kruparellia/claude-contribution-/vision/refs/red_rock_close/10.jpg

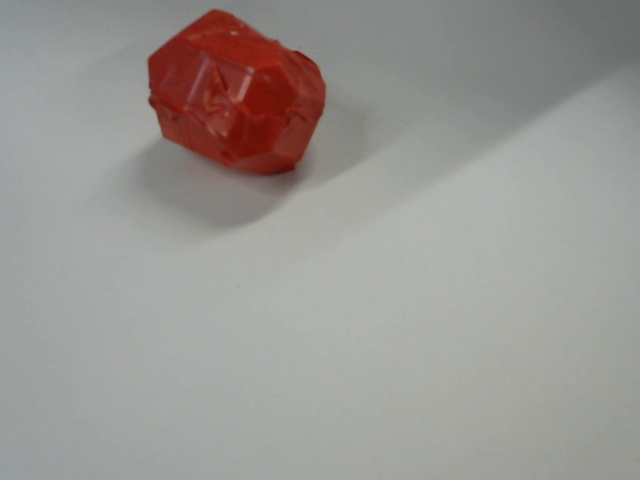
vision/refs/red_rock_close/10.jpg
