kruparellia/claude-contribution-/vision/refs/red_rock_oldcam/08.jpg

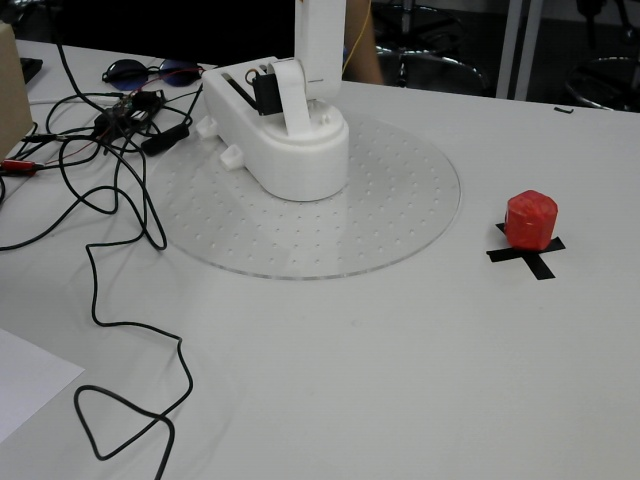
vision/refs/red_rock_oldcam/08.jpg
