kruparellia/claude-contribution-/README.md

# Embeded-Robot-Arm-CW
Advanced Industrial Robotic Arm using RF Wireless Communication for Industrial Applications. This is for our Embedded Systems Year 3 coursework.
