kruparellia/claude-contribution-/EE6003_Report/sections/09_teamwork.tex

% =====================================================================
% Teamwork & individual contributions  (~150 words; thin first draft)
% =====================================================================
\section{Teamwork and Individual Contributions}
\label{sec:teamwork}

The team of three partitioned work along the lines suggested by the
marking rubric. \textbf{Member~A} (mechanical lead) was responsible
for the SolidWorks design, 3D printing iterations and physical
assembly. \textbf{Member~B} (electronics lead) led hardware
schematics, sensor interfacing and wiring of both units.
\textbf{Member~C} (integration lead, the present author) led firmware,
the wireless protocol design, the autonomous-mode FSM, the
computer-vision integration and the report write-up. All three
members participated in testing and in producing the demonstration
video.

% TODO: insert the agreed Gantt chart / task allocation table once
% the team has finalised the per-week breakdown.
\begin{table}[t]
  \centering
  \caption{Individual contribution summary (to be finalised).}
  \footnotesize
  \begin{tabularx}{\columnwidth}{lX}
    \toprule
    \textbf{Member} & \textbf{Primary contributions} \\
    \midrule
    A & CAD, 3D printing, mechanical assembly, gripper iterations \\
    B & Schematics, sensor interfacing, power architecture, wiring \\
    C & Firmware, protocol, FSM, vision, integration, report \\
    \bottomrule
  \end{tabularx}
\end{table}

Independent peer feedback will be submitted to the module lead via
Canvas as required by the brief.
