kruparellia/claude-contribution-/EE6003_Report_Scaffold/sections/09_teamwork.tex

% =====================================================================
% Teamwork & Individual Contributions  --  TARGET: ~250 words
% Marking weight: 10 marks. Submitted in the report;
% confidential peer-feedback goes separately to Canvas per the brief.
% =====================================================================
\section{Teamwork and Individual Contributions}
\label{sec:teamwork}

\guide{
The brief's individual-contribution requirement covers eight
deliverable areas (Abstract / Lit Review, System Design, Hardware,
Software, Mechanical/CAD, Testing, Teamwork, Report Writing). Map
each member to the areas they led. The 1st+ rubric wants
``exceptional teamwork with outstanding coordination and equal
contribution.''

For top marks, include:
\begin{itemize}
  \item A contribution table (member $\rightarrow$ areas led).
  \item One paragraph per member describing primary contributions,
        impact on the team, and any cross-area support given.
  \item A short paragraph on team process: how tasks were allocated,
        how blockers were escalated, how decisions were recorded.
  \item Brief mention that confidential peer feedback was submitted
        independently to the module lead via Canvas, as required.
\end{itemize}
Avoid: blame, vague contributions like ``helped with everything'',
or unbalanced framing.
}

\subsection{Contribution summary}
\placeholder{[\ldots brief paragraph introducing the three members
and their lead areas\ldots]}

\begin{table}[t]
  \centering
  \caption{Individual contribution summary.}
  \footnotesize
  \begin{tabularx}{\columnwidth}{lX}
    \toprule
    \textbf{Member} & \textbf{Primary contributions} \\
    \midrule
    A & [\ldots e.g.\ CAD, 3D printing, mechanical assembly\ldots] \\
    B & [\ldots e.g.\ schematics, sensor interfacing, power\ldots] \\
    C & [\ldots e.g.\ firmware, protocol, FSM, integration\ldots] \\
    \bottomrule
  \end{tabularx}
\end{table}

\subsection{Team process}
\placeholder{[\ldots one paragraph: weekly stand-ups, shared task
board, source-control workflow (Git), and how blockers were
escalated and resolved\ldots]}

\subsection{Peer feedback}
\placeholder{[\ldots one short paragraph noting that each member
submitted confidential professional feedback for the other two
members directly to the module lead via Canvas, as required by the
brief\ldots]}
