kruparellia/claude-contribution-/EE6003_Report_Scaffold/sections/10_conclusion.tex

% =====================================================================
% Discussion, Future Work & Conclusion  --  TARGET: ~300 words
% =====================================================================
\section{Discussion and Future Work}
\label{sec:futurework}

\guide{
This section pulls together the advanced-feature claims that justify
marks above the 60\,\% ceiling. List them explicitly, in priority
order, then say what the next planned extensions are.

For Future Work, the highest-credibility extensions are ones that
build on infrastructure you've already laid. Strong candidates:
\begin{itemize}
  \item Migrate Mega super-loop to ArduinoFreeRTOS task scheduling
        (the firmware was already structured to allow this).
  \item Add an nRF24L01+ as a redundant wireless channel.
  \item Replace 3D-printed gears with anti-backlash pairs.
  \item Add a force-sensitive gripper for grasp-quality feedback.
  \item ESP32 / Pi vision pipeline migration to ML-based
        classification (e.g.\ MobileNet on the Pi).
\end{itemize}
Pick three or four; explain what each one would require and what
metric it would improve.
}

\placeholder{[\ldots one paragraph listing the principal
advanced-feature claims of this submission, with brief justification
for each\ldots]}

\placeholder{[\ldots one paragraph on planned extensions, prioritised,
each with the metric it improves\ldots]}

\section{Conclusion}
\label{sec:conclusion}

\guide{
Three sentences:
\begin{enumerate}
  \item One sentence stating what was built.
  \item One sentence stating that all six brief objectives are
        addressed.
  \item One sentence stating which advanced features push the grade
        above the upper-2:1 ceiling.
\end{enumerate}
End with a sentence pointing to the demonstration video and code in
the supplementary zip.
}

\placeholder{[\ldots three to four sentences. End with a pointer to
the demonstration video and the supplementary code archive.\ldots]}
