kruparellia/claude-contribution-/EE6003_Report/figures/01_power_architecture.pdf

## Power architecture — arm side

Servos and Arduino get power from different sources. Grounds are tied together.

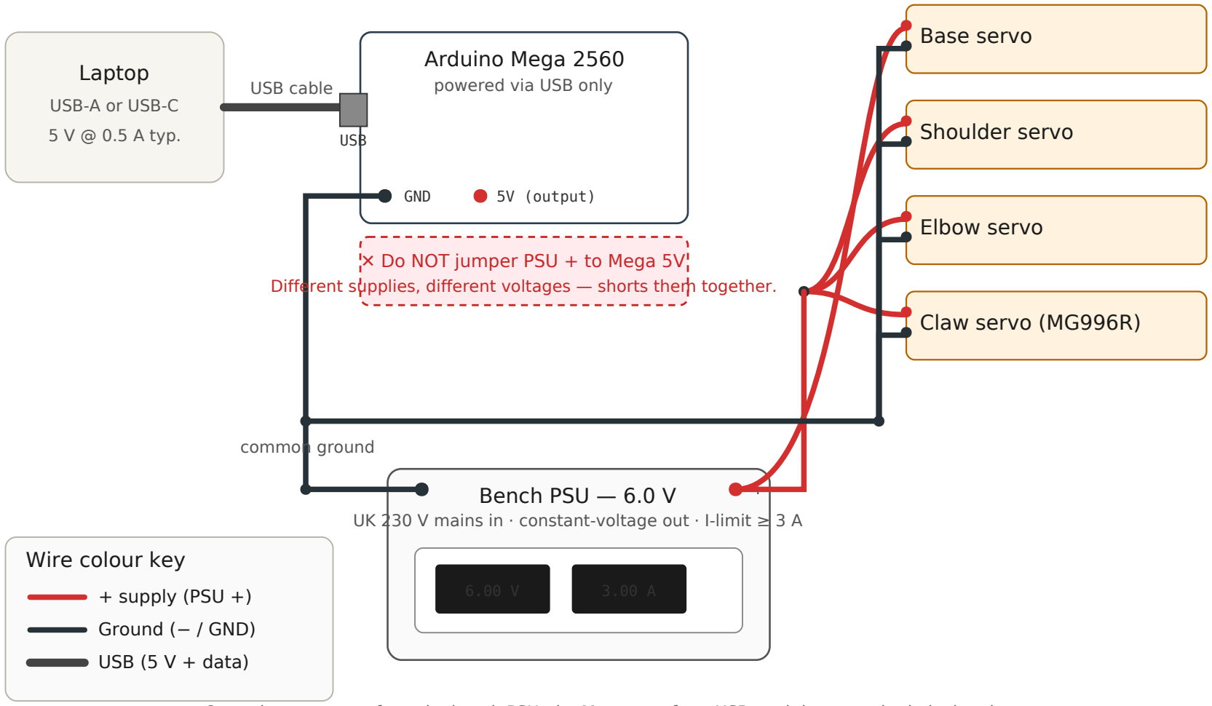
[picture p3: figure]
Laptop; USB-A or USB-C; 5 V @ 0.5 A typ.; USB cable; Arduino Mega 2560 powered via USB only; USB; GND; 5V (output); Base servo; Shoulder servo; Elbow servo; Claw servo (MG996R); Bench PSU — 6.0 V; common ground; ✕ Do NOT jumper PSU + to Mega 5V; Wire colour key; + supply (PSU +); Ground (− / GND); USB (5 V + data)

UK 230 V mains in · constant-voltage out · I-limit ≥ 3 A

Different supplies, different voltages — shorts them together.

One rule: servos eat from the bench PSU, the Mega eats from USB, and the grounds shake hands.
