kruparellia/claude-contribution-/EE6003_Report/figures/02_hc05_voltage_divider.pdf

## HC-05 RX voltage divider

Drops the Arduino's 5 V TX signal to ≈ 3.3 V before it reaches the HC-05 RX V_out = 5 V × R2 / (R1 + R2) = 5 × 2/3 ≈ 3.33 V

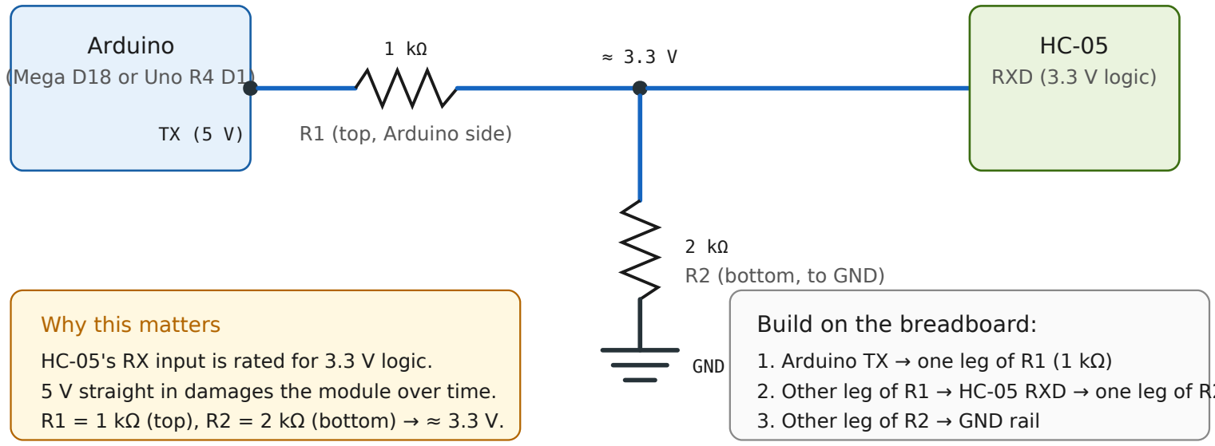
[picture p4: figure]
Arduino (Mega D18 or Uno R4 D1); R1 (top, Arduino side); RXD (3.3 V logic); 2 kΩ R2 (bottom, to GND); GND (shared); Why this matters; Build on the breadboard:; 1. Arduino TX → one leg of R1 (1 kΩ); 3. Other leg of R2 → GND rail

HC-05's RX input is rated for 3.3 V logic.
5 V straight in damages the module over time. R1 = 1 kΩ (top), R2 = 2 kΩ (bottom) → ≈ 3.3 V.
2. Other leg of R1 → HC-05 RXD → one leg of R2 (2 kΩ
