kruparellia/claude-contribution-/vision/markers/aruco_sheet_20mm_ids5-6-7-8.pdf

ID 5 20mm | ID 6 20mm | ID 7 20mm | ID 8 20mm

verify: 25 mm

## CLAW TIP — ArUco DICT_4X4_50 20 mm IDs [5, 6, 7, 8]
