kruparellia/claude-contribution-/vision/markers/aruco_id10_50mm.pdf

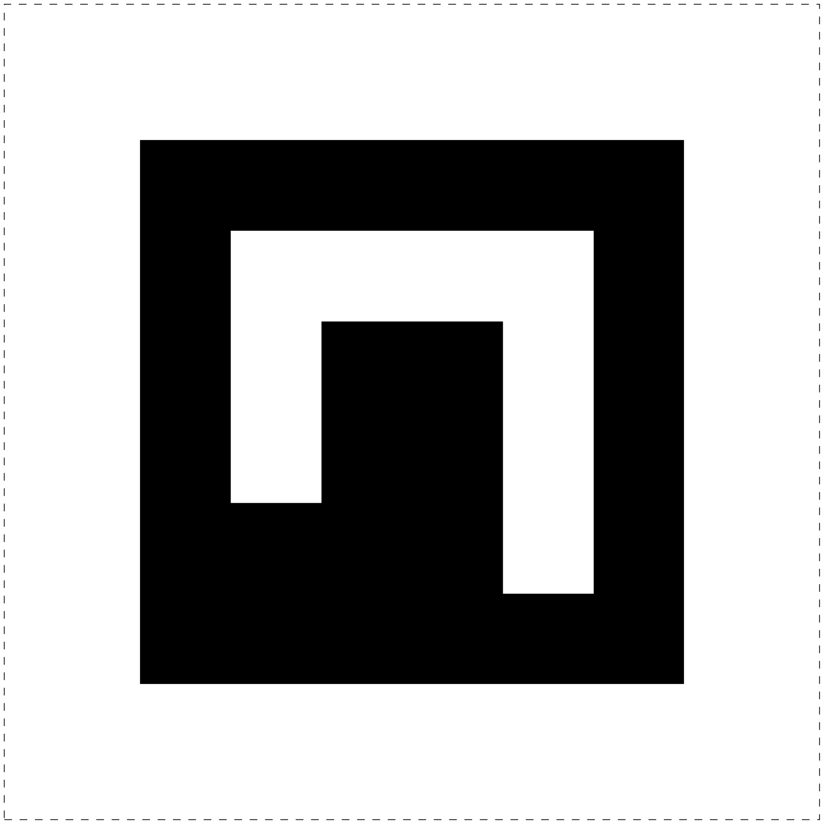
[picture p5: figure]

BASE HEADING — ArUco DICT_4X4_50 ID 10 50 mm

verify: 25 mm
