kruparellia/claude-contribution-/vision/markers/aruco_id00_25mm.pdf

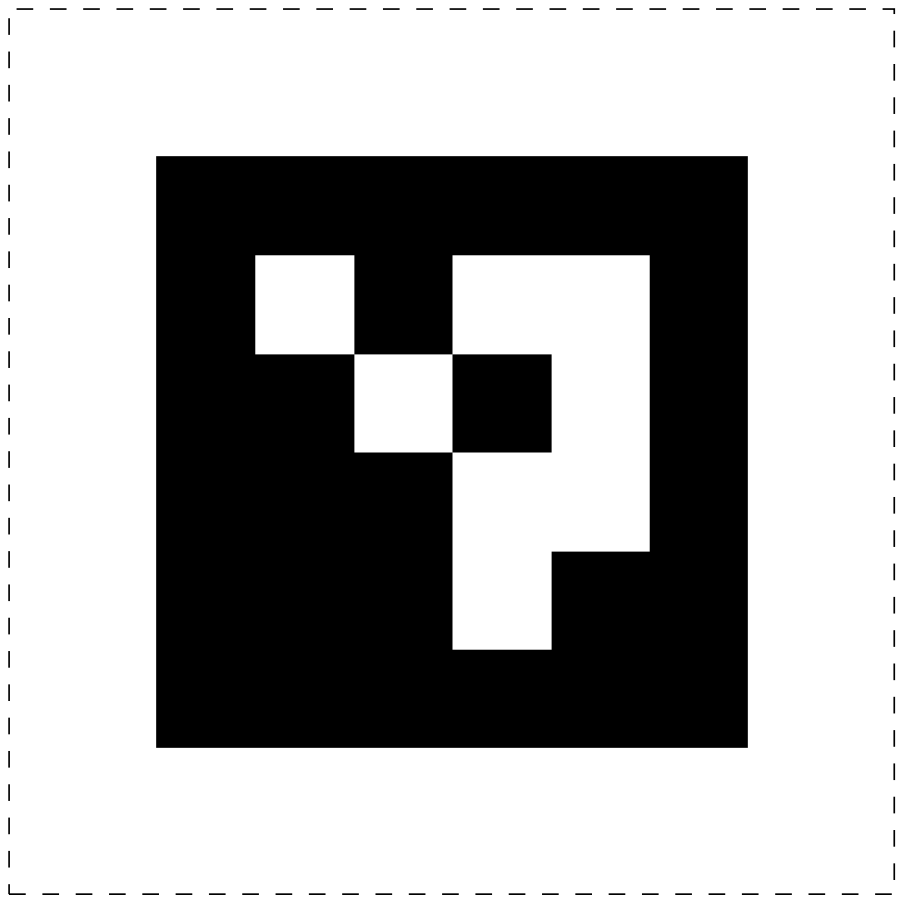
[picture p6: figure]

ArUco DICT_4X4_50 ID 0 25 mm

verify: 25 mm
