kruparellia/claude-contribution-/vision/markers/aruco_id01_25mm.pdf

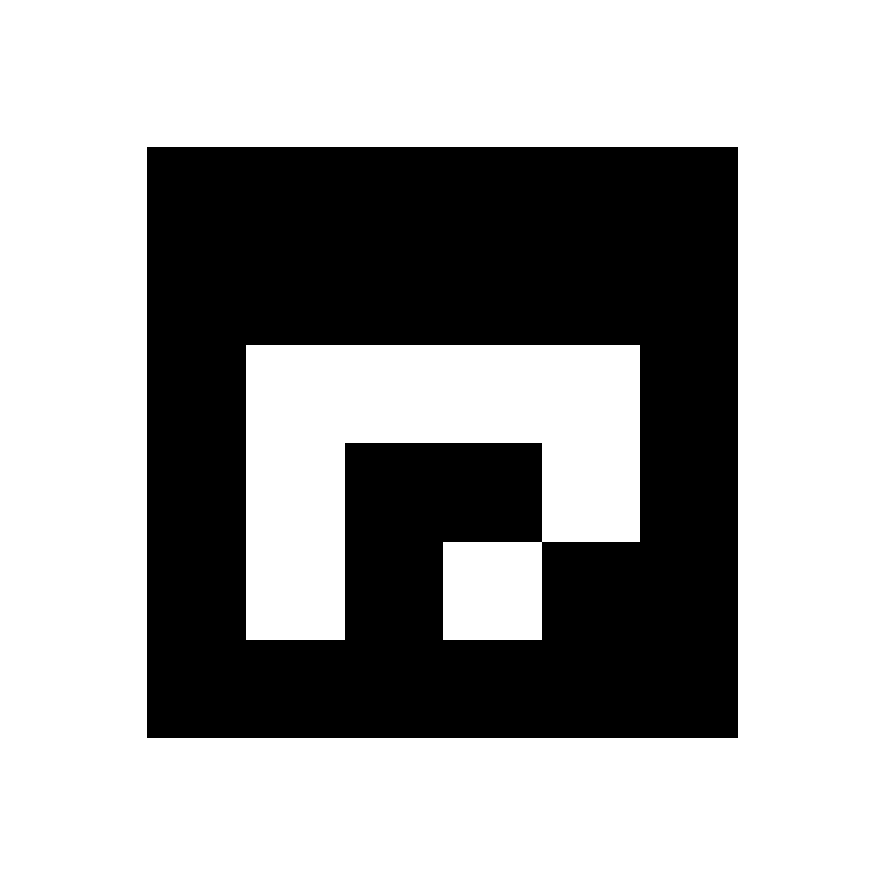
[picture p7: figure]

ArUco DICT_4X4_50 ID 1 25 mm

verify: 25 mm
