kruparellia/claude-contribution-/vision/markers/aruco_id02_25mm.pdf

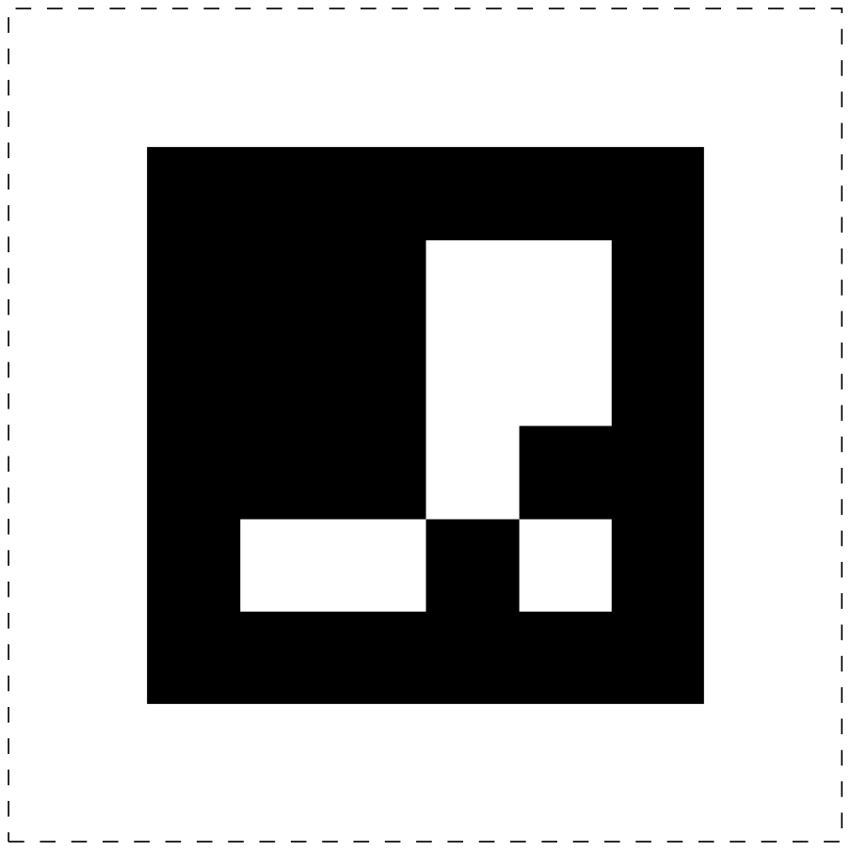
[picture p8: figure]

ArUco DICT_4X4_50 ID 2 25 mm

verify: 25 mm
