kruparellia/claude-contribution-/vision/markers/aruco_id03_25mm.pdf

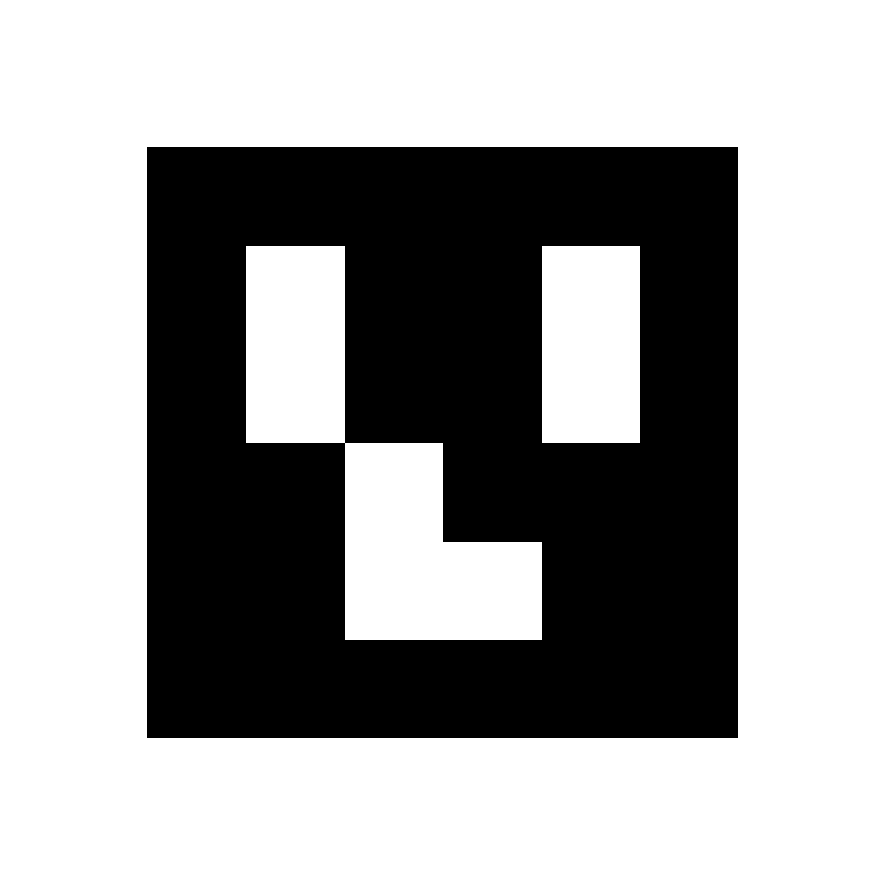
[picture p9: figure]

ArUco DICT_4X4_50 ID 3 25 mm

verify: 25 mm
