kruparellia/claude-contribution-/vision/markers/aruco_id00_25mm.png

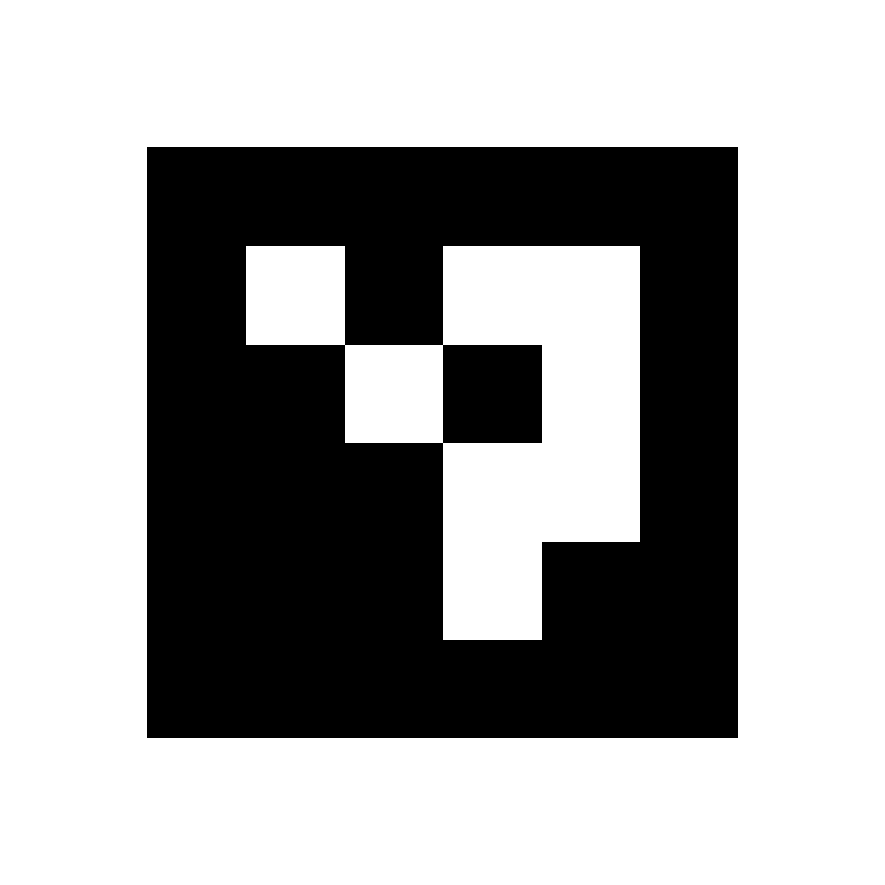
vision/markers/aruco_id00_25mm.png
