kruparellia/claude-contribution-/vision/markers/aruco_id02_25mm.png

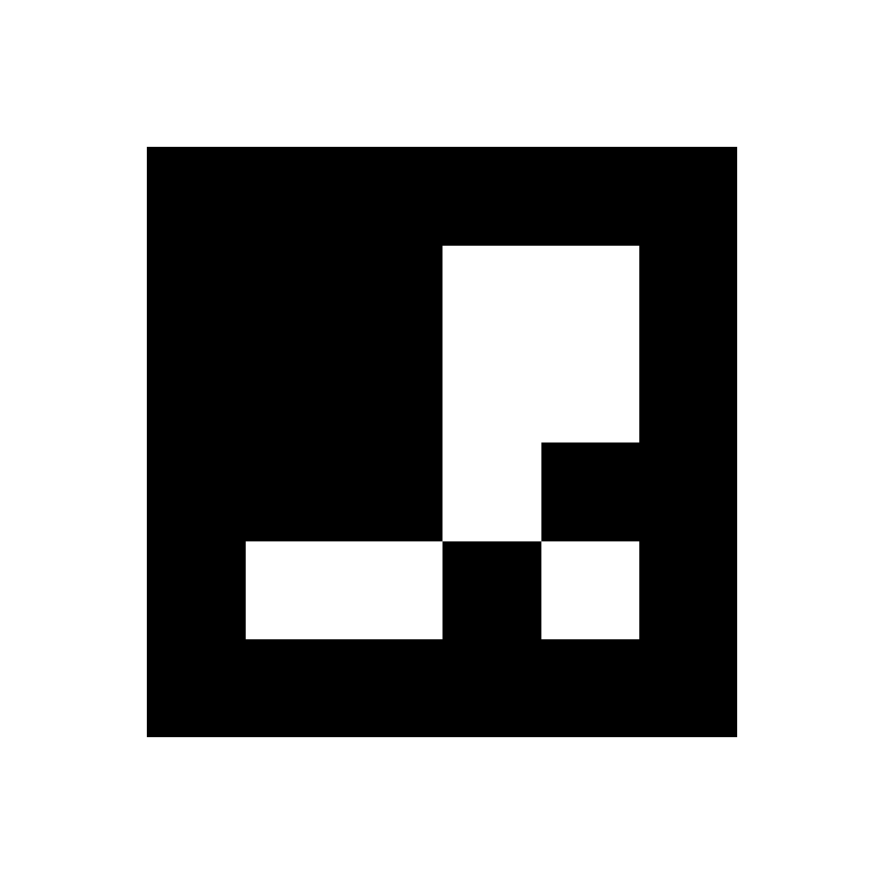
vision/markers/aruco_id02_25mm.png
