kruparellia/claude-contribution-/vision/markers/aruco_id10_50mm.png

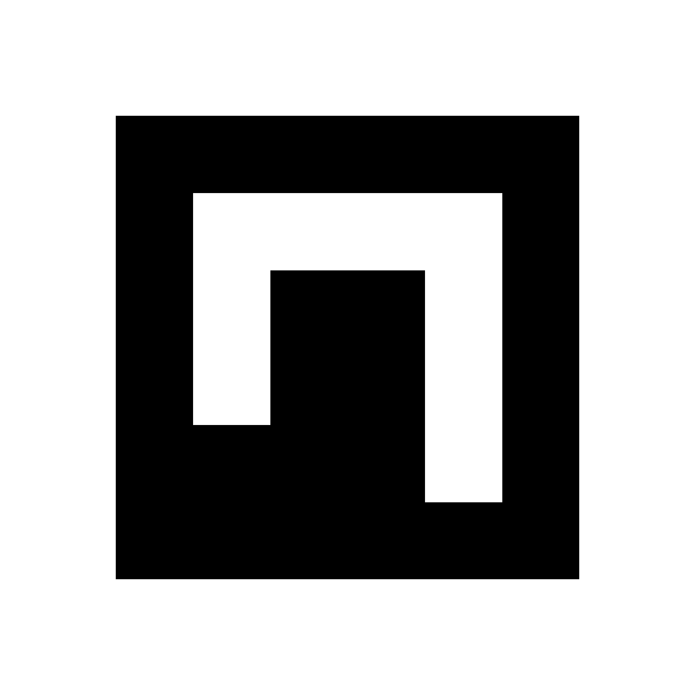
vision/markers/aruco_id10_50mm.png
