kruparellia/claude-contribution-/vision/refs/red_rock_close/01.jpg

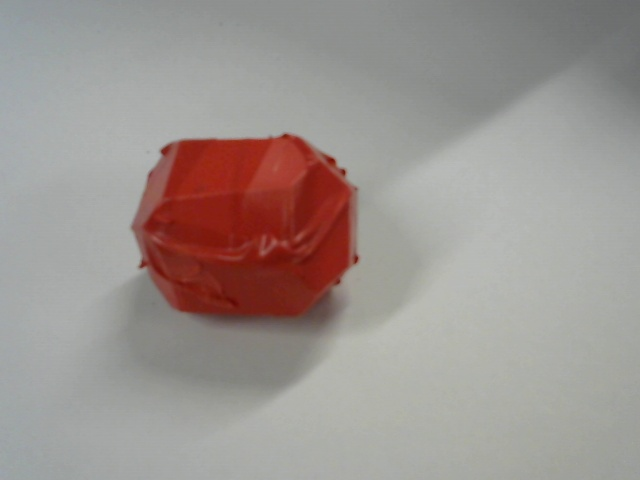
vision/refs/red_rock_close/01.jpg
