kruparellia/claude-contribution-/vision/refs/red_rock_close/03.jpg

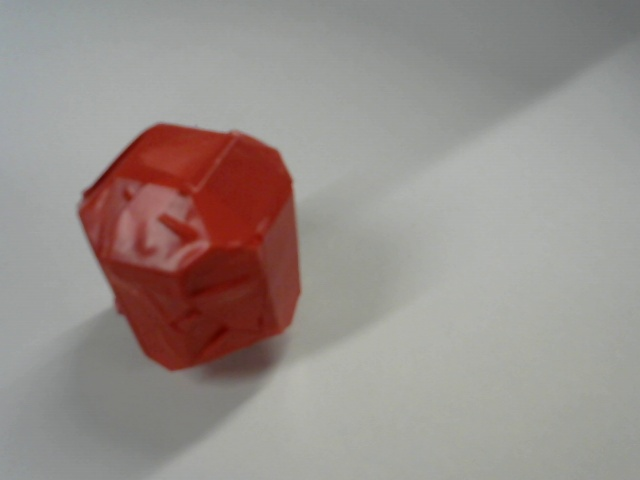
vision/refs/red_rock_close/03.jpg
