kruparellia/claude-contribution-/vision/refs/red_rock_close/04.jpg

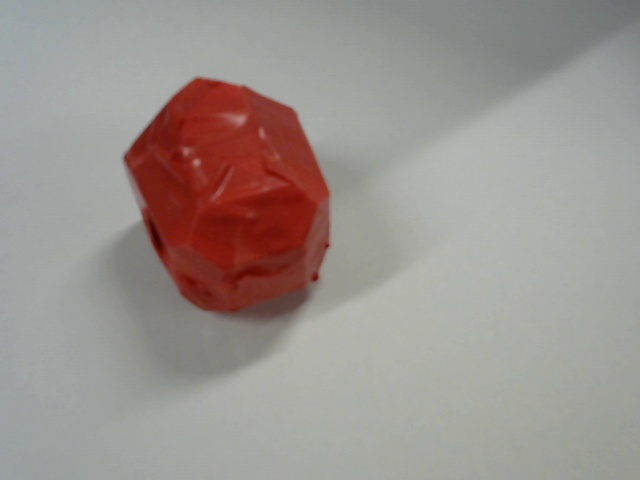
vision/refs/red_rock_close/04.jpg
