kruparellia/claude-contribution-/vision/refs/red_rock_close/05.jpg

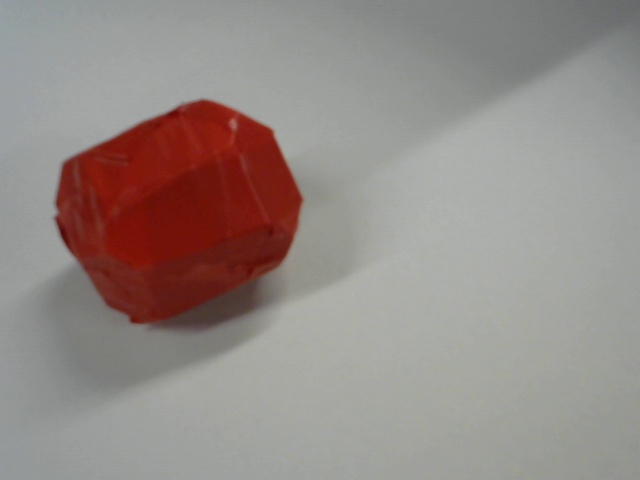
vision/refs/red_rock_close/05.jpg
