kruparellia/claude-contribution-/vision/refs/red_rock_close/06.jpg

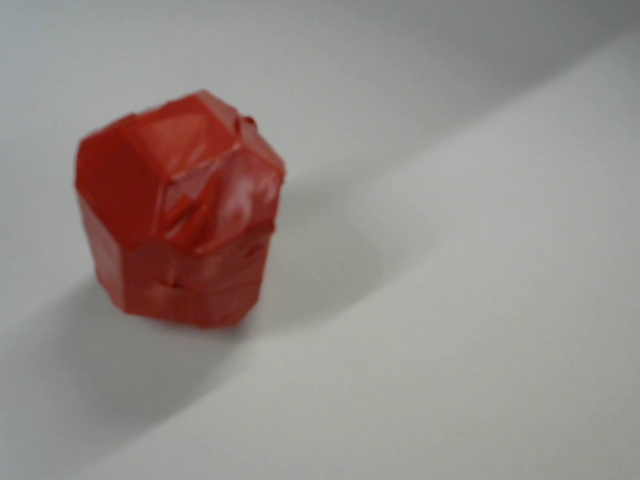
vision/refs/red_rock_close/06.jpg
