kruparellia/claude-contribution-/vision/refs/red_rock_close/07.jpg

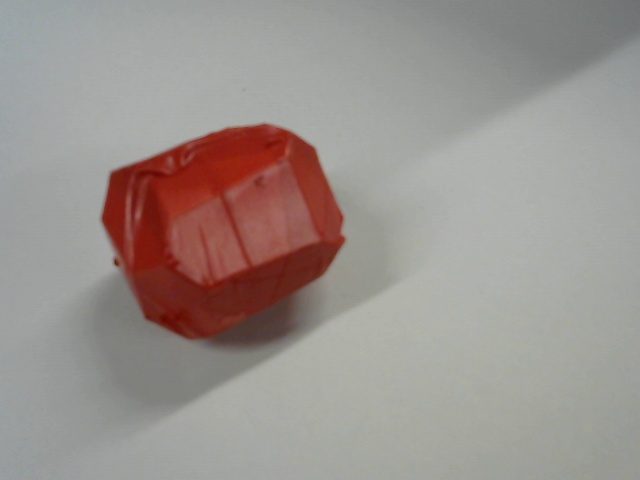
vision/refs/red_rock_close/07.jpg
