kruparellia/claude-contribution-/vision/refs/red_rock_close/08.jpg

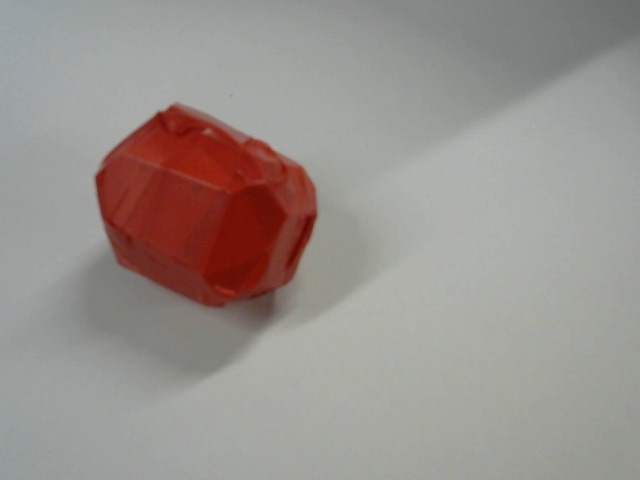
vision/refs/red_rock_close/08.jpg
