kruparellia/claude-contribution-/vision/refs/red_rock_close/11.jpg

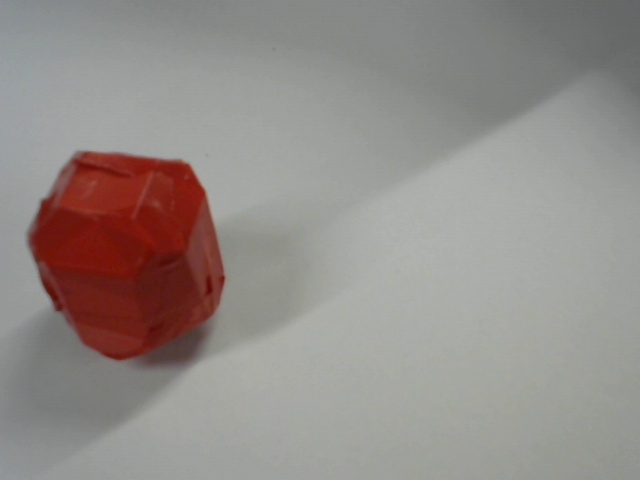
vision/refs/red_rock_close/11.jpg
