kruparellia/claude-contribution-/vision/refs/red_rock_close/12.jpg

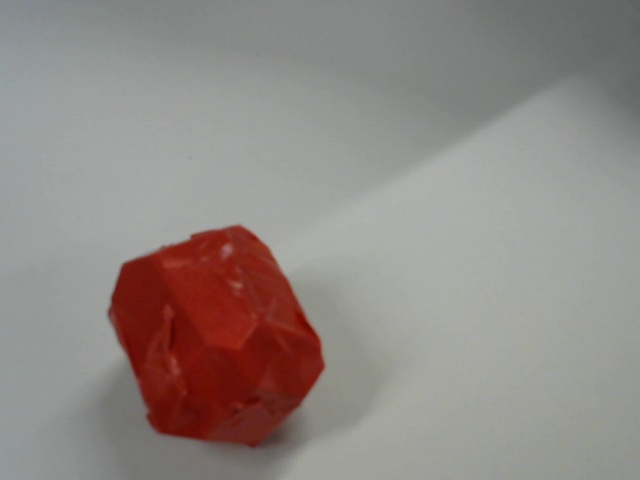
vision/refs/red_rock_close/12.jpg
