kruparellia/claude-contribution-/vision/refs/red_rock_close/13.jpg

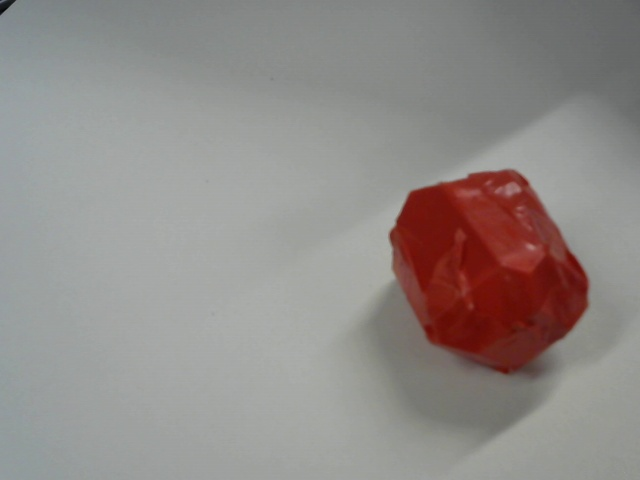
vision/refs/red_rock_close/13.jpg
