kruparellia/claude-contribution-/vision/refs/red_rock_close/14.jpg

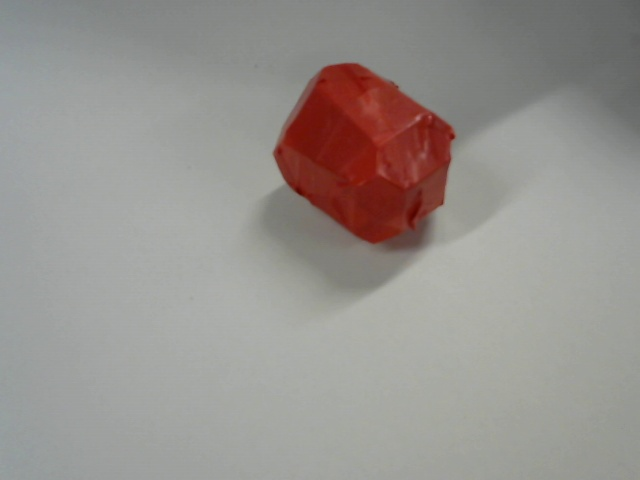
vision/refs/red_rock_close/14.jpg
