kruparellia/claude-contribution-/vision/refs/red_rock_close/15.jpg

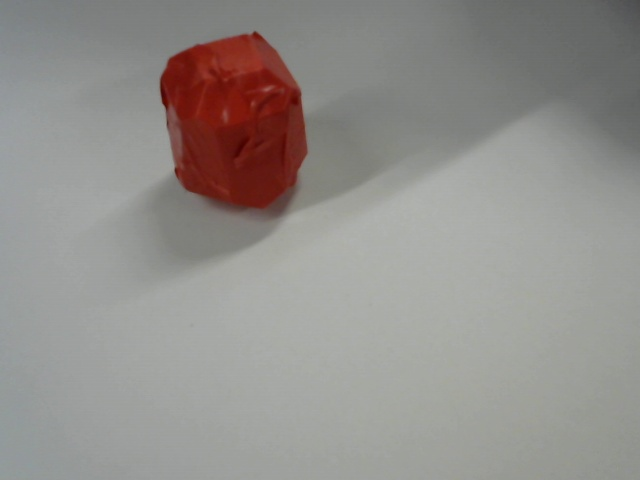
vision/refs/red_rock_close/15.jpg
