kruparellia/claude-contribution-/vision/refs/red_rock_close/17.jpg

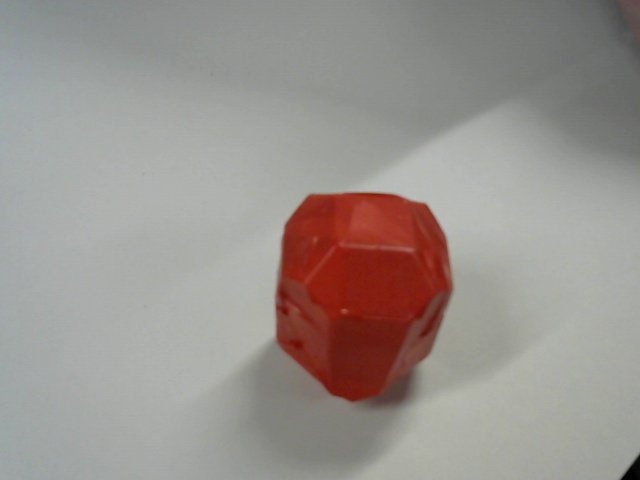
vision/refs/red_rock_close/17.jpg
