kruparellia/claude-contribution-/vision/refs/red_rock_close/18.jpg

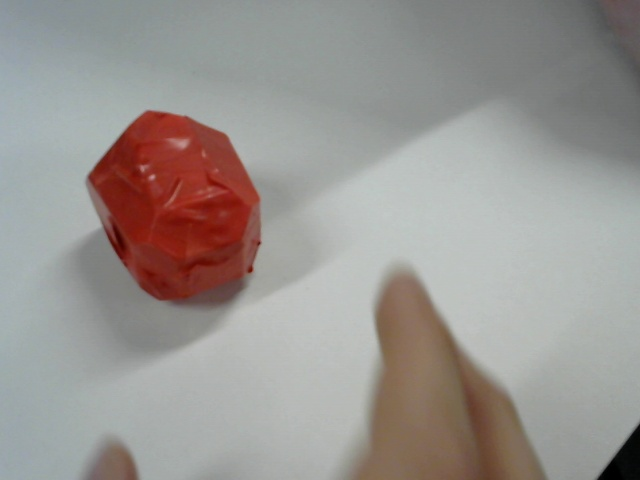
vision/refs/red_rock_close/18.jpg
