kruparellia/claude-contribution-/vision/refs/red_rock_oldcam/17.jpg

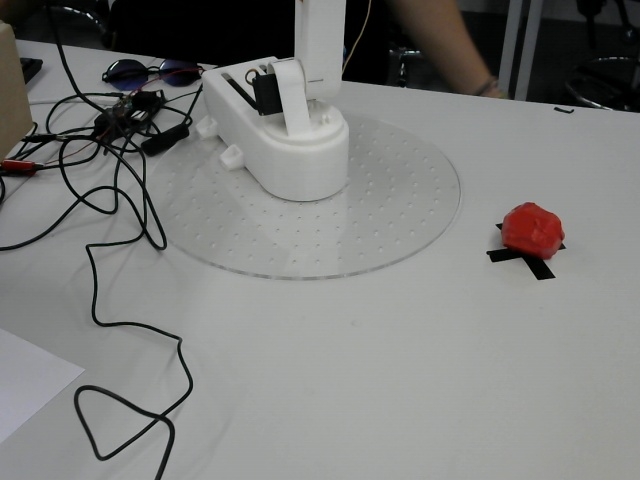
vision/refs/red_rock_oldcam/17.jpg
