kruparellia/claude-contribution-/vision/refs/red_rock_oldcam/19.jpg

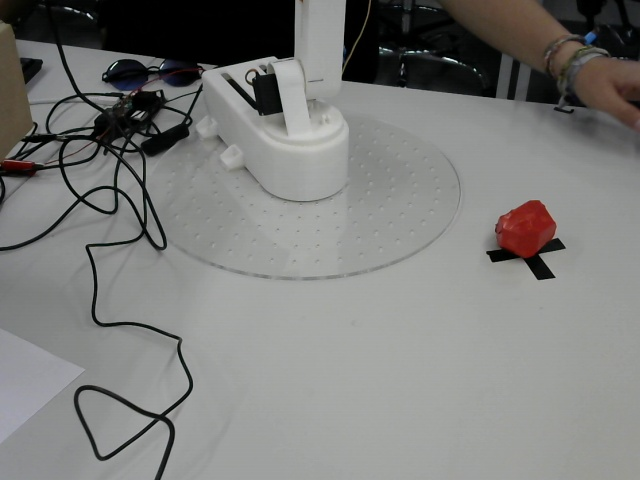
vision/refs/red_rock_oldcam/19.jpg
