kruparellia/claude-contribution-/vision/refs/red_rock_oldcam/25.jpg

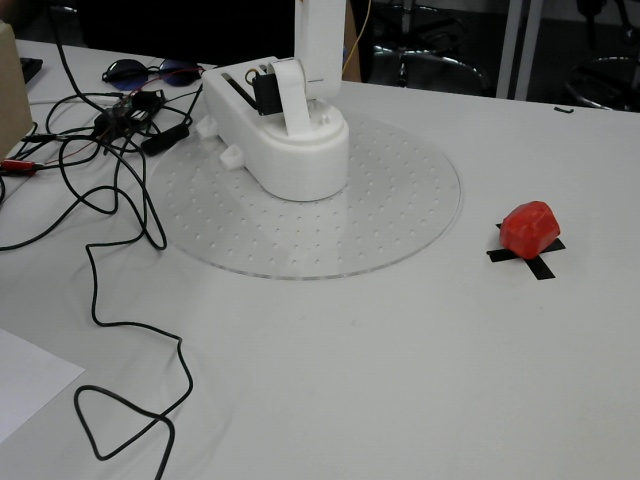
vision/refs/red_rock_oldcam/25.jpg
