kruparellia/claude-contribution-/Servo Motor Implementation/joystick_mg996r_uno_r4_guide.html

# Controlling an MG996R Servo with a Joystick and Arduino UNO R4

A practical starter guide for your robotic arm project. This focuses on one joystick and one MG996R first, because that is the safest way to prove the control method before you scale up to multiple joints and mechanical load.

Start with 1 servo + 1 joystick

Use external 5–6 V servo power

Use the joystick from the SunFounder kit first

Keep angle limits conservative

## 1) Recommended first approach

For a first working prototype, use:

- Arduino UNO R4 Minima
- SunFounder joystick module
- One MG996R servo motor
- External 5–6 V power supply for the servo
- Common ground between the Arduino and the servo power supply

Why this is the best first step: it lets you tune the joystick feel, prove the servo wiring, and learn the safe angle range of the MG996R before you attach a heavy mechanical arm.

Important: do not power an MG996R directly from the Arduino 5 V pin when you are doing real motion tests. The MG996R is a higher-current servo and can draw large current spikes, especially when loaded or stalled.

## 2) Parts and what each one does

- Joystick module: gives two analog readings (X and Y) and one push-button switch.
- Arduino UNO R4: reads the joystick and sends position commands to the servo.
- MG996R servo: contains an internal motor, gears, control circuit, and position feedback inside the servo so it can move to a commanded angle.
- External power supply: provides enough current for the servo without browning out the Arduino.

The joystick from the SunFounder kit is enough to start. You do not need a second joystick yet unless later you want a more natural two-hand or multi-axis control style.

## 3) Things to be aware of before you wire it

- Do not force the servo horn by hand when powered.
- Do not command angles beyond the real mechanical range of your servo setup.
- Do not let the servo push into a hard stop for long periods.
- Do not attach a heavy arm immediately. Bench-test the control first.
- If the servo buzzes harshly at an endpoint, reduce the allowed angle range immediately.

Most important safety point: if the servo is commanded past its safe endpoint, current rises sharply and the servo can overheat, stall, or damage the mechanism.

## 4) Wiring / connections to the Arduino UNO R4

Use the wiring below for your first test rig.

Part | Pin / wire | Connect to | Notes
Joystick module | VCC | UNO R4 5V | The joystick module is low current and is fine from the board 5V.
Joystick module | GND | UNO R4 GND | Required reference for analog readings.
Joystick module | VRx | A0 | X-axis analog input.
Joystick module | VRy | A1 | Y-axis analog input (unused in the first sketch, but wire it now).
Joystick module | SW | D2 | Push-button input. The example uses INPUT_PULLUP.
MG996R servo | Signal (orange/yellow) | D9 | Servo control signal from the Arduino.
MG996R servo | Power (red) | External 5–6 V + | Do not use the Arduino 5V pin for serious servo power.
MG996R servo | Ground (brown/black) | External supply GND | Servo return path.
Arduino UNO R4 | GND | External supply GND | Common ground is essential.

         JOYSTICK MODULE                          ARDUINO UNO R4
      ---------------------                  ----------------------
      VCC  ------------------------------->  5V
      GND  ------------------------------->  GND
      VRx  ------------------------------->  A0
      VRy  ------------------------------->  A1
      SW   ------------------------------->  D2

         MG996R SERVO                           EXTERNAL 5–6 V SUPPLY
      ---------------------                  ----------------------
      Red (+) ----------------------------->  +5 V / +6 V
      Brown/Black (GND) ------------------->  GND
      Orange/Yellow (Signal) ------------->  D9 on Arduino

         VERY IMPORTANT
      Arduino GND ------------------------->  External supply GND

## 5) How the control should work

1. The Arduino reads the joystick X-axis with analogRead(A0).
2. The joystick value is roughly centred in the middle when untouched.
3. The code maps that joystick value to a safe servo angle range.
4. The code applies a deadzone so the servo does not twitch around the centre.
5. The code applies slew/rate limiting, meaning the servo moves gradually rather than snapping instantly to the new target.
6. The Arduino sends the resulting target angle to the servo using the Servo library.

This gives you a much nicer feel than mapping the joystick directly to the servo with no filtering.

## 6) Why we use deadzone and smoothing

### Deadzone

The joystick never sits at a perfect centre value. If you map the raw reading directly to the servo, the servo may jitter even when you are not touching the stick. A deadzone tells the program to treat small centre movement as zero movement.

### Slew / rate limiting

Instead of jumping straight to the new target angle, the code changes the servo command in small steps each loop. This makes motion look smoother and reduces shock on the gears and mechanism.

## 7) Why angle limits matter

Not every servo really behaves like a perfect 0–180 degree device. The MG996R is often described as a standard position servo, but its safe travel depends on the exact unit, horn setup, and load.

- Start with a conservative range such as 30° to 150°.
- Only widen the range after you test carefully.
- If the servo buzzes or strains at either end, reduce the allowed range.
- Once a mechanical arm is attached, software limits become even more important.

## 8) Starter Arduino code

This sketch gives you a solid first version for one MG996R controlled by the joystick X-axis. It includes:

- safe servo angle limits,
- deadzone around the joystick centre,
- gradual motion for smoother control,
- serial output for debugging.

#include <Servo.h>

Servo jointServo;

// --- Pins ---
const int joyXPin = A0;
const int joyYPin = A1;   // not used yet, but wired for later
const int joySWPin = 2;
const int servoPin = 9;

// --- Servo limits ---
// Start conservatively for MG996R until you verify your real range safely
const int servoMin = 30;
const int servoMax = 150;

// --- Joystick settings ---
const int joyCenter = 512;     // default 10-bit centre is roughly 512
const int deadzone = 35;       // tweak to reduce twitching

// --- Motion settings ---
float currentAngle = 90.0;
float targetAngle  = 90.0;
const float maxStepPerLoop = 1.5;   // lower = smoother/slower, higher = faster

void setup() {
  Serial.begin(9600);

  pinMode(joySWPin, INPUT_PULLUP);

  jointServo.attach(servoPin);
  jointServo.write((int)currentAngle);

  delay(500); // let things settle
}

void loop() {
  int rawX = analogRead(joyXPin);

  // Deadzone around centre
  if (abs(rawX - joyCenter) < deadzone) {
    rawX = joyCenter;
  }

  // Map joystick to safe servo angle range
  targetAngle = map(rawX, 0, 1023, servoMin, servoMax);

  // Slew-rate limit: move gradually toward target
  if (currentAngle < targetAngle) {
    currentAngle += maxStepPerLoop;
    if (currentAngle > targetAngle) currentAngle = targetAngle;
  } else if (currentAngle > targetAngle) {
    currentAngle -= maxStepPerLoop;
    if (currentAngle < targetAngle) currentAngle = targetAngle;
  }

  jointServo.write((int)currentAngle);

  // Debug output
  Serial.print("rawX: ");
  Serial.print(rawX);
  Serial.print("  target: ");
  Serial.print(targetAngle);
  Serial.print("  current: ");
  Serial.println(currentAngle);

  delay(10);
}

## 9) Code walkthrough

### Pin definitions

A0 reads the joystick X-axis. A1 is wired ready for later expansion. D2 reads the joystick push-button. D9 sends the servo control signal.

### Servo limits

servoMin and servoMax set the allowed angle window. These stop the software from commanding extreme positions too early in development.

### Deadzone

If the joystick is close to the centre value, the code snaps it back to centre so the servo does not chatter.

### Rate limiting

maxStepPerLoop limits how much the servo command changes every pass through the loop. Smaller values give smoother but slower motion.

## 10) How to tune the feel

- Servo too twitchy near centre? Increase deadzone.
- Servo too slow? Increase maxStepPerLoop.
- Servo too jumpy? Decrease maxStepPerLoop.
- Need a wider range? Carefully adjust servoMin and servoMax.
- Servo hits a stop or buzzes? Reduce the range immediately.

Tune one thing at a time. Start with the servo disconnected from the arm mechanism if possible.

## 11) Suggested test procedure

1. Upload the code with the servo horn removed.
2. Verify the joystick values look sensible in the Serial Monitor.
3. Check that the servo moves smoothly left and right.
4. Leave the joystick centred and make sure the servo stays calm rather than twitching.
5. Test the safe angle limits before attaching any mechanical load.
6. Only then fit the horn and start linking it to your arm mechanism.

A very good habit is to test the servo range with no arm attached, then test again with the mechanism attached, because the real safe limits often shrink once the linkage geometry is involved.

## 12) Common problems and fixes

### Servo jittering badly

- Check the common ground.
- Use a better external servo supply.
- Increase the deadzone.

### Servo resets the Arduino or causes weird behaviour

- The servo is probably pulling too much current from the wrong supply path.
- Move the servo to a proper external 5–6 V source.

### Servo buzzes at one end

- You are likely commanding past its safe endpoint or into a hard mechanical stop.
- Reduce the angle range.

## 13) Good next steps after this works

1. Use joystick X for one joint and Y for a second joint.
2. Use the joystick push switch to change which joint is selected.
3. Build the first mechanical link and test with small loads.
4. Add software limits per joint once the geometry is known.
5. Only after manual control feels reliable should you add wireless control or autonomous sensing.

## 14) References / technical basis

- Arduino Servo library documentation and basic servo control tutorials.
- Arduino UNO R4 Minima user manual / hardware documentation for power guidance.
- SunFounder joystick module documentation for joystick analog pin behaviour and switch use.
- MG996R datasheet sources for voltage, current, and torque guidance.

Prepared as a practical setup guide for bench testing joystick-to-servo control before moving on to the full robotic arm build.
