kruparellia/claude-contribution-/pio-project/diagrams/wiring.html

# EE6003 Robotic Arm — Wiring Diagrams

Visual companion to WIRING.md. Open each diagram in a new tab to zoom.

1. Power architecture (read this first) 2. HC-05 voltage divider (the 2 kΩ / 1 kΩ detail) 3. Arm side — full wiring 4. Controller side — full wiring

## 1. Power architecture

File: 01_power_architecture.svg

Power architecture: USB powers the Mega, 6 V bench PSU powers the servos, grounds shared

This is the single most important diagram. Two separate power sources feed the arm:

1. The laptop's USB supplies the Mega (5 V at up to ~500 mA, plenty for the microcontroller).
2. The 6 V bench PSU (UK 230 V mains in, constant-voltage out, current limit ≥ 3 A) supplies the four servos.

The two supplies share one node: ground. Without that common return path, the servo signal from the Mega and the servo's own reference voltage disagree, and the servos twitch or refuse to respond.

Never do this The PSU's + must not touch the Mega's 5V pin, VIN, or any red rail that carries USB 5 V. You'd be shorting two supplies with different voltages — best case, the USB host cuts power; worst case, something smokes.

## 2. HC-05 voltage divider

File: 02_hc05_voltage_divider.svg

Voltage divider with 2k and 1k resistors, dropping 5V to 3.3V on the HC-05 RX line

Both Arduinos in this project output 5 V logic. The HC-05's RX input is rated for 3.3 V. Feeding 5 V straight in works for a while, then kills the module.

The fix is a resistive divider between the Arduino TX pin and the HC-05 RX pin:

1. R1 = 1 kΩ, in series, between Arduino TX and the junction.
2. R2 = 2 kΩ, from the junction down to GND.
3. The HC-05 RX pin connects at the junction itself.

The voltage at the junction is V_out = V_in × R2 / (R1 + R2) = 5 V × 2 / (1 + 2) ≈ 3.33 V — exactly what the HC-05 wants. If you want belt-and-braces, a proper 3.3 V level shifter IC (TXS0108E, BSS138) is bulletproof and no arithmetic to get wrong.

## 3. Arm side — full wiring

File: 03_arm_wiring.svg

Full arm-side wiring showing Mega 2560, 4 MG996R servos, HC-05 with divider, and 6 V bench PSU with common ground

Everything that lives on the arm base. Follow the coloured wires:

1. Red — 6 V from PSU+ up to each servo V+ (shared rail).
2. Dark — GND. PSU−, all four servo GNDs, and Mega GND all meet at one junction (the common-ground node highlighted on the diagram).
3. Amber — servo PWM signal wires. D9 → base, D10 → shoulder, D11 → elbow, D6 → claw.
4. Blue — TX1 (D18) from Mega into the divider, then on to HC-05 RXD.
5. Green — TXD from HC-05 straight into Mega RX1 (D19). No divider needed because 3.3 V is read as HIGH by the Mega's 5 V input.

Bulk capacitor A 220–470 µF electrolytic across the servo V+/GND rail, close to the servos, prevents brown-outs when all four accelerate at once. Long leg to +, short leg to −. With the bench PSU it isn't strictly required, but it costs nothing and keeps the rail clean.

## 4. Controller side — full wiring

File: 04_controller_wiring.svg

Full controller-side wiring showing Uno R4 Minima, two KY-023 joysticks, HC-05 master with divider

The handheld controller has four things attached to the Uno R4 Minima: two KY-023 joysticks, the HC-05 master, and a USB cable (to your laptop during development; later, a power bank in the USB-C jack).

Upload gotcha — worth reading twice The HC-05 TXD wire on D0 blocks USB uploads. Every time you want to re-flash the Uno R4, pop that single jumper off D0, upload, and put it back. The D1 side can stay wired.

Joystick mapping in firmware:

- Joystick 1 (left) — VRx → A0, VRy → A1, SW → D2 · drives base + shoulder.
- Joystick 2 (right) — VRx → A2, VRy → A3, SW → D3 · drives elbow + claw.

Both SW pins use internal pull-ups. Long-press either SW (≥ 1 s) snaps the arm back to home. If an axis feels backwards once you're moving the arm, flip the sign of the matching jNx/jNy term in controller_uno_r4/main.cpp. To compare diagonal-allowed vs strictly-orthogonal motion, set #define DIAGONAL_GATE 1 in the same file.
