kruparellia/claude-contribution-/EE6003_Report/figures/03_arm_wiring.pdf

# Arm side — full wiring

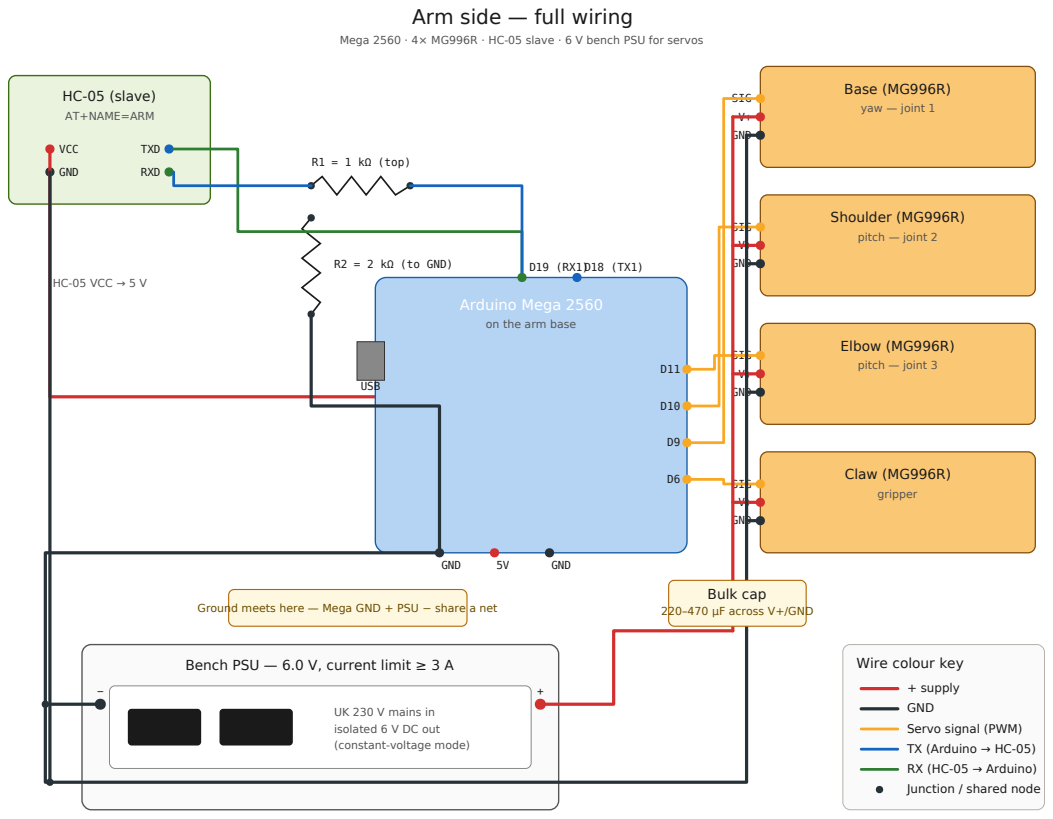
[picture p32: page 1]
VCC; GND; TXD; RXD; R1 = 1 kΩ (top); HC-05 VCC → 5 V; USB; Base (MG996R); yaw — joint 1; Shoulder (MG996R); pitch — joint 2; Elbow (MG996R); pitch — joint 3; Claw (MG996R); gripper; SIG V+; SIG V+ GND; Bulk cap

Mega 2560 · 4× MG996R · HC-05 slave · 6 V bench PSU for servos

HC-05 (slave)
AT+NAME=ARM

GND SIG

V+

R2 = 2 kΩ (to GND)

Arduino Mega 2560
on the arm base

GND

Ground meets here — Mega GND + PSU − share a net

220–470 µF across V+/GND

Bench PSU — 6.0 V, current limit ≥ 3 A

Wire colour key

+ supply
Servo signal (PWM)
TX (Arduino → HC-05)
RX (HC-05 → Arduino)
Junction / shared node

UK 230 V mains in
isolated 6 V DC out
(constant-voltage mode)
