kruparellia/claude-contribution-/EE6003_Report/figures/04_controller_wiring.pdf

# Controller side — full wiring (two joysticks)

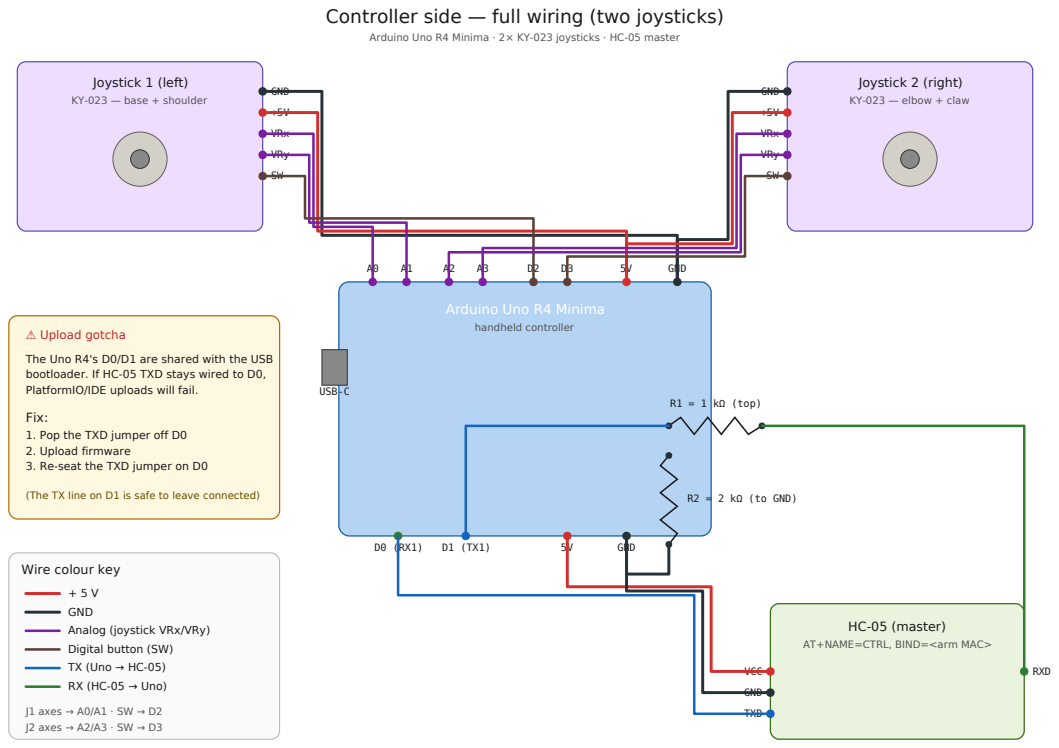
[picture p33: page 1]

Arduino Uno R4 Minima · 2× KY-023 joysticks · HC-05 master

⚠ Upload gotcha
The Uno R4's D0/D1 are shared with the USB
bootloader. If HC-05 TXD stays wired to D0,
PlatformIO/IDE uploads will fail.
Fix:
1. Pop the TXD jumper off D0
2. Upload firmware
3. Re-seat the TXD jumper on D0

(The TX line on D1 is safe to leave connected)

GND
Analog (joystick VRx/VRy)
Digital button (SW)
TX (Uno → HC-05)
RX (HC-05 → Uno)

AT+NAME=CTRL, BIND=<arm MAC>
