kruparellia/claude-contribution-/(commit log)

2026-04-23 Initial commit: EE6003 robotic arm project
    Includes PlatformIO source code (arm, controller, HC-05 config),
    wiring diagrams, protocol library, docs, and assessment brief.
2026-04-23 Add arduino code bluetooth + servo motor
2026-04-25 Two joysticks control 4 servo motors, either in x and y constrained motion or diagonal motion. Wiring diagrams + README updated.
2026-04-25 Add python orchestrator script, a script that sends home command to motors from keyboard. Uno cpp script changed to accept the new 'home' keyboard input from the home.py script. Assoc README's update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
2026-04-25 Fix compilation error where copiler thought j1 means a maths function and not the joystick1, renamed to 'stick1' and 'stick2' respectively.
    [main.cpp]
2026-04-30 Camera implementation code
2026-05-14 Vision system updates: Using classical CV approach now, works at approx 30cm away when camera can focus. Detects red rock when surrounded by other red objects even at different angles.
2026-05-14 Add automated movement recorder to pre-defind location. Movement is included in mega/main.cpp as keyframes.h header file.Automated movement is OFF by default and must be at home to function. Over usb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
2026-05-21 Flash all .py doesn't fail silently and builds both envs first and then flashes and shows correct errors and skips that device if it's not connected. Modified platformio.ini so that it uses the lates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
    [flash_all.py]
2026-05-27 Halve global servo slew rate from 120 to 60 deg/s.
    Open-loop control was losing sync at the shoulder when commanded to large
    angle steps where torque is high. Slowing down slew so motor has more time to adjust.
2026-05-27 Add special input curve to shoulder/elbow joysticks on the v2 controller.
    Joystick deflection was scaling linearly, but now it's cubic. Small deflections now give
    gentle motion; full deflection still reaches MAX_RATE. Base (button spin)
    and claw (absolute pot) are still linear.
2026-05-27 Drop controller MAX_RATE from 90 to 60 deg/s to match arm slew limit.
    The controller was still integrating commanded angle at up to 90 deg/s, which meant full-deflection
    holds built up a queue of "commanded angle ahead of where the arm
    actually is". Released sticks would then leave the arm continuing to
    chase that queue for a moment — felt like stop-overshoot.
    [main.cpp]
2026-05-27 Fix pickup sequence aborting on every BT heartbeat frame.
    Previously, auto sequence was aborted when ANY frame arrived
    from controller, not when the user actually moved it.
    Has to move 2 degrees to actually override the auto mode.
    [main.cpp]
2026-05-27 Defence-in-depth clamp in slewAndWrite() before pushing to the servo.
    Means a future change that writes a `current`
    from outside the normal path can't push
    a value past the mechanical limit. Bullet-proof the boundary even
    though it currently holds.
2026-05-27 Remove ESP32 camera firmware and Mega-side camera link code.
    Project has moved to Pi-side vision (Logitech C270 + OpenCV in
    vision/colour_detect.py) and the on-board ESP32-WROVER CAM is no longer
    used — fragile hardware and less robust than C270.
    Arm-side flash dropped ~1.2 KB; Mega RAM frees ~80 bytes of static state.
    HC-05 path and pickup sequence are untouched.
    [main.cpp]
2026-05-27 Delete v1 controller, rename v2 -> controller_uno_r4.
    The original 4-axis joystick firmware (v1) and the v2 two-stick + claw-pot
    firmware were both buildable, and flash_all.py let you pick either. With
    the project committed to the v2 scheme this is just confusing —
    git history covers "what did v1 look like" if anyone ever needs to look
    back to see. Changes made:
    - rename src/controller_uno_r4_v2/ -> src/controller_uno_r4/
    - rename WIRING_v2.md -> WIRING.md, reframe from "addendum to v1" into
    the project's primary controller wiring guide
    - rewrite the Control Scheme section of README.md (was describing the
    v1 4-axis layout + DIAGONAL_GATE which doesn't exist any more)
    - up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
    [flash_all.py, main.cpp]
2026-05-27 Sleep briefly in python visino script when a frame read fails.
    cap.read() failures (USB cable drop, camera removed) made the main loop
    continue immediately, spinning the Pi 4B at 100% CPU and flooding the
    console with the retry warning. Sleep 50 ms before the next retry so a
    disconnected camera stays a cheap no-op until it's plugged back in.
    [colour_detect.py]
2026-05-28 Remap controller sticks and buttons.
    Shoulder/elbow now use joystick X-axis instead of Y, and elbow
    direction is inverted so down-stick lifts. Base-spin buttons
    swapped: J1 SW is CW, J2 SW is CCW.
    [main.cpp]
2026-05-28 Hold claw at HOME until the pot is deliberately twisted.
    Raised POT_NOISE to 15 (measured floor is ~20 counts) and added
    POT_ARM_DELTA so the pot only drives the claw after the knob moves
    >50 counts from its boot reading. snapHome() and c<deg> rebase the
    boot reading so homed/cal values stick.
    [main.cpp]
2026-05-28 Update HOME pose to {142, 30, 113, 21}.
    Captured from the arm while parked in the desired starting pose.
    Controller HOME, arm LIM_*.initial, and KF_HOME plus the placeholder
    keyframes are updated together so both sides agree.
2026-05-28 Add vision/arm_link.py - Pi-side wrapper for arm USB serial.
    Auto-detects the Mega by USB VID/PID and wraps the single-letter
    commands the arm already accepts (p/x/h/a/?). Includes an
    interactive REPL for verifying the link by hand.
2026-05-28 Let auto mode coexist with a powered-on BT controller.
    Heartbeat BT frames are now ignored while seqAutoMode is on so
    Pi-set targets aren't stomped, and any controller activity (any
    angle change or FLAG_BUTTON) flips auto off and aborts the sequence.
    'a' refuses to turn auto ON while the controller has moved in the
    last 500 ms.
    [main.cpp]
2026-05-29 Add double-tap on elbow joystick button to home the arm.
2026-05-29 Add ArUco marker generator with print-ready PDFs.
2026-05-29 Add live ArUco detector for verifying printed markers.
2026-05-29 Rebuild red_rock shape refs at the new camera distance.
2026-05-29 Add servo_diagnostic.py to preview the visual-servo correction.
    [servo_diagnostic.py]
2026-05-29 Add pickup_runner.py — vision-gated pickup trigger.
2026-06-07 Add shoulder lift interlock + staged home; reset HOME, widen limits
    Rebuilt arm: reset HOME to the claw's new resting pose {74,68,55,21}
    (LIM_*.initial, KF_HOME, controller HOME) and widen travel — shoulder
    hi 140->155, elbow to 0..180 — for more reach.
    Fix the shoulder stalling when lowered far enough to cantilever the
    forearm out (gravity torque > MG996R stall torque; it "loses power" and
    can't lift back up):
    - Shoulder lift interlock: past SHOULDER_LIFT_GATE_DEG (80) the shoulder
    won't rise until the elbow is folded back >= ELBOW_LIFT_SAFE_DEG (165),
    pulling the forearm mass in to shrink the lever arm. Enforced on the
    controller (up-commands are dropped, not banked, so nothing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
    [main.cpp]
2026-06-08 Reset HOME to {90,36,55,21} across firmware; add --label to make_markers
    Finishes the rebuilt-arm HOME/limit reset on both firmware sides, and adds
    the optional --label flag used to generate the ID-10 BASE HEADING marker.
    [main.cpp, make_markers.py]
2026-06-08 Base registration tooling + rebuild rock refs at final rig
    - base_outline.py: segment white base disc, fit ellipse -> centre + green
    outline, ID-10 (50 mm) gives px/mm. Rough disc-ellipse centre accepted
    (closed loop self-corrects; holes too low-contrast to fit reliably).
    - base_register.py: oblique->top-down homography rectification diagnostic
    (kept for reference; superseded by the simpler disc-outline approach).
    - servo_diagnostic.py: centre-based correction (atan2 about base centre,
    replaces px/deg placeholder); claw estimate now uses ONLY claw markers
    0-3, excluding base marker 10 which was corrupting it.
    - aruco_tune.py: A/B harness for detector params (tuning tested, did NOT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
    [aruco_tune.py, base_outline.py, base_register.py, servo_diagnostic.py]
2026-06-11 Add arm auto-mode self-drive with bumpless handoff and open the claw fully at home
2026-06-11 Switch arm_link to newline-terminated commands and add hover/base-nudge helpers
2026-06-11 Rewrite pickup servo to align claw-tip ArUco markers directly onto the rock
2026-06-11 Add A4 multi-marker sheet output and generate the 20 mm claw-tip tags
2026-06-11 Add servo/base visual-servo calibration state files
    [servo_jacobian.json, servo_k.json]
2026-06-11 Add auto-mode grasp+drop: pick the aligned rock and place it on the drop zone
    Wires up the final pickup step. Once pickup_runner has visually-servoed the
    claw over the rock (ALIGNED), it fires the new firmware 'g' command which runs
    GRASP_DROP_SEQUENCE from the current hover pose — grasp, lift, swing to the
    fixed red-tape drop zone, release, and home — all hands-off (AUTO_GRASP).
    Firmware (arm_mega):
    - BASE_KEEP keyframe sentinel: pickup-phase frames hold the visually-servoed
    base so alignment survives; the drop phase snaps to the recorded drop angle.
    - New 'g' / seqStartGrasp(): runs from the current pose (no at-home gate),
    auto-mode only. Sequence runner generalised to a shared ac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
    [servo_jacobian.json]
2026-06-11 Verify pickup by camera: confirm the rock left the spot after the cycle
    After GRASPING completes, the runner homes the arm (clearing the pickup spot
    from view) and enters a new VERIFYING state that re-checks the spot with the
    shape-gated detector: an empty spot means the rock was carried away (PICKUP
    OK); a rock still on the X means the grasp failed (PICKUP FAILED). Samples 10
    frames and flags failure on >=4 hits so one noisy frame can't flip the result.
    Reusing the shape gate keeps the red drop tape from being mistaken for the
    rock. Result shown as an on-screen banner + console tally; no auto-retry yet.
    [servo_jacobian.json]
2026-06-11 Add damped e-stop rocker switch (manual + auto)
    A rocker on D2 (read with the internal pull-up, fail-safe: open/disconnected =
    stopped) gives a soft e-stop that holds position instead of cutting power, so
    the arm doesn't go limp and drop its load. On engage it aborts any sequence/
    home, drops out of auto, pins every joint to its current angle, and opens the
    claw fully; it ignores all Bluetooth and motion USB commands while engaged
    (status/debug still allowed) and re-asserts the hold every tick. On release it
    holds pose and resumes manual control (auto stays off; re-arm deliberately),
    bumplessly. Boots stopped if the rocker is already engaged. '?' now reports
    estop=yes/no. ESTOP_ENGAGED_LEVEL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
    [main.cpp]
2026-06-11 Add future-work doc: physical UI, open issues, multi-colour sort guide
    Planning/reference doc with three guides: (1) replacing the on-screen cv2 UI
    with a Pi-GPIO LED + button panel for screen/keyboard-free auto operation
    (setup-vs-run split, wiring, state->LED table, panel.py + --headless plan);
    (2) unresolved issues and likely brief gaps (colour sort, joint-level PID,
    telemetry, debug-code cleanup, robustness); (3) adding more colours with
    detect-by-shape/classify-by-colour and a runtime-selectable per-colour drop
    zone (BASE_DROP sentinel + g<deg>).
